keeratS/445team27/README.md

# 445team27
a repo to serve as a git-based lab notebook for the work of Team 27 in ECE 445
