keeratS/445team27/notebooks/jyotsna/AC_data_collection_2_19_2022.png

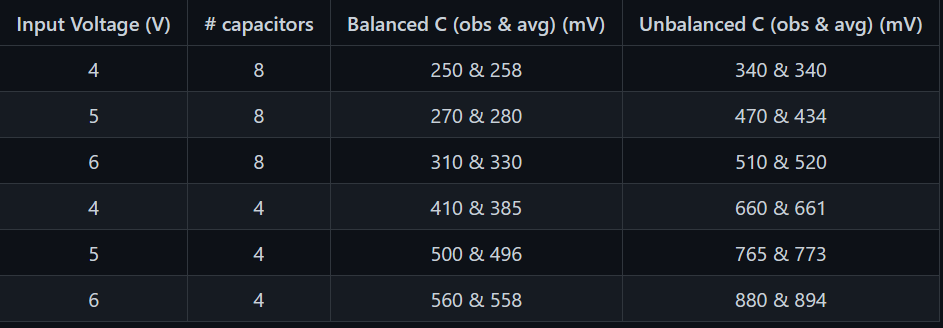
notebooks/jyotsna/AC_data_collection_2_19_2022.png
