keeratS/445team27/notebooks/jyotsna/block_diagram_DDC.png

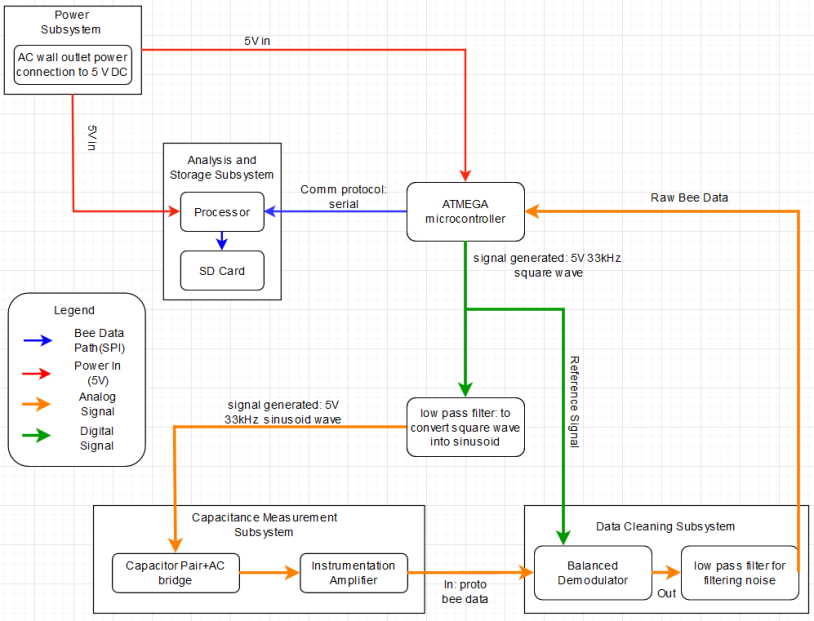
notebooks/jyotsna/block_diagram_DDC.png
