keeratS/445team27/notebooks/keerat/beehouse_dim.jpg

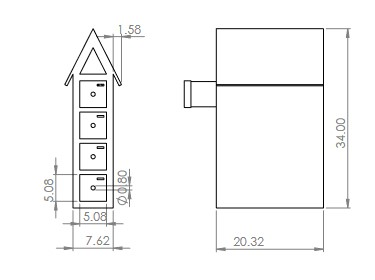
notebooks/keerat/beehouse_dim.jpg
