keeratS/445team27/notebooks/keerat/capacitor_pair_dim.jpg

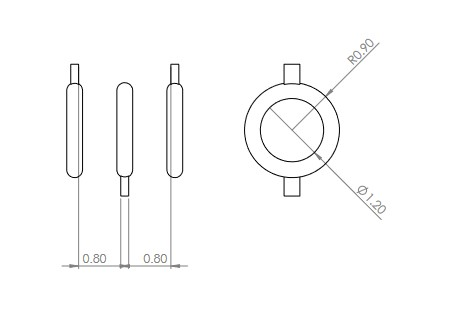
notebooks/keerat/capacitor_pair_dim.jpg
