keeratS/445team27/notebooks/keerat/Change in AC Bridge Output Voltage vs Input Voltage.png

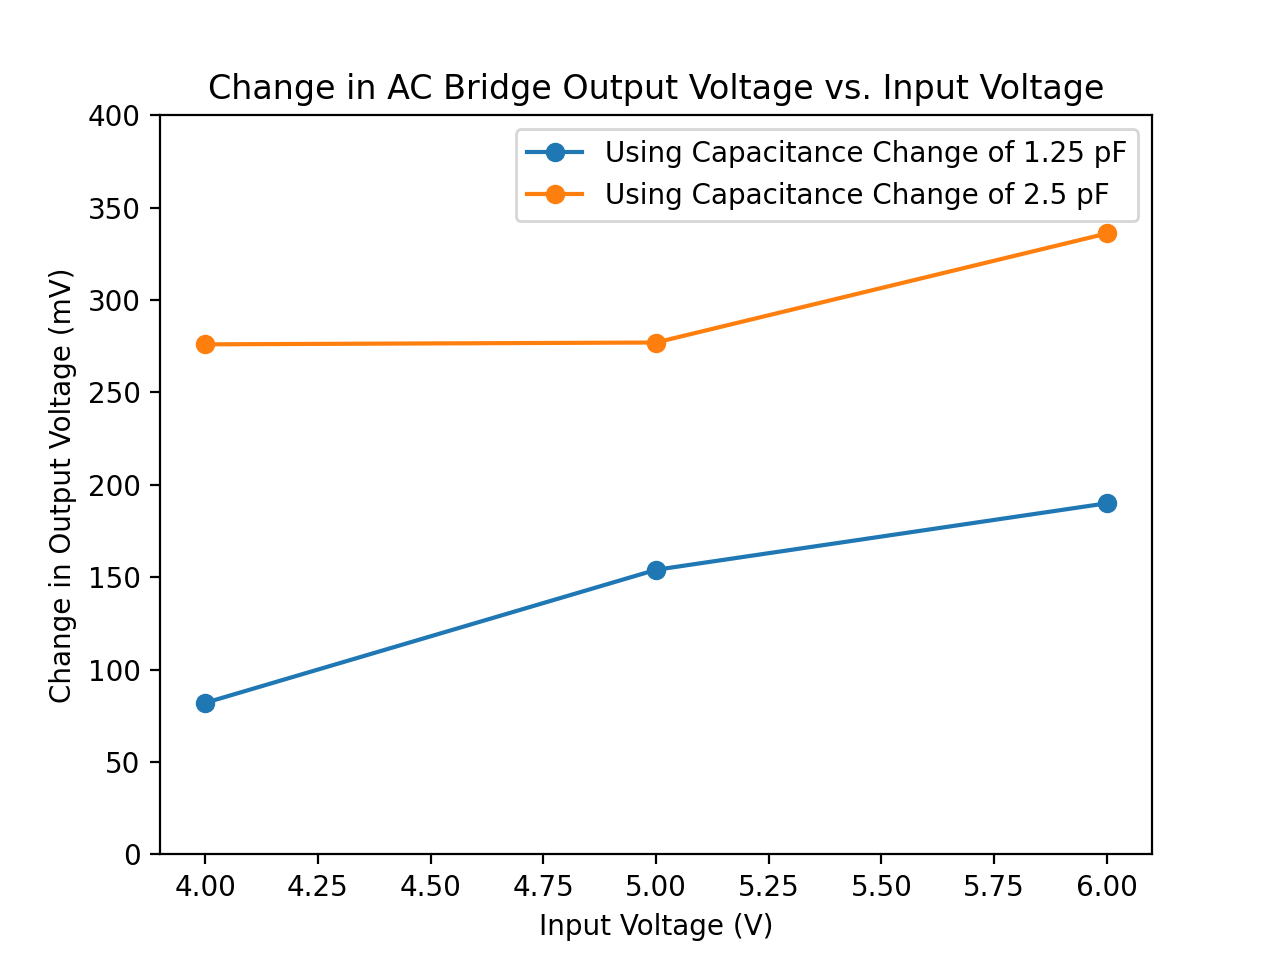
notebooks/keerat/Change in AC Bridge Output Voltage vs Input Voltage.png
