keeratS/445team27/notebooks/keerat/deltacapvsdeltaV.png

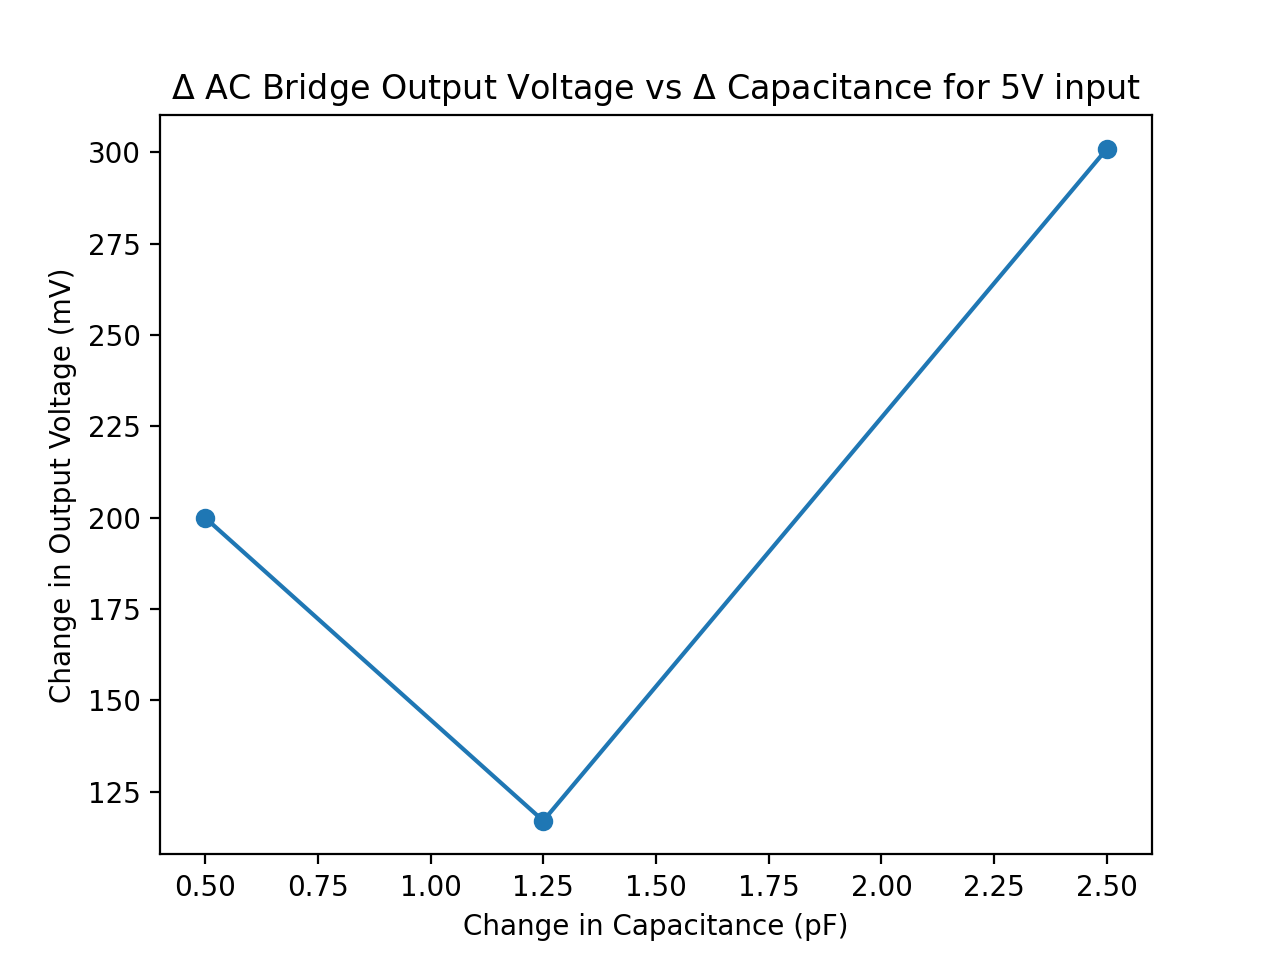
notebooks/keerat/deltacapvsdeltaV.png
