keeratS/445team27/notebooks/keerat/tunnel_dim.jpg

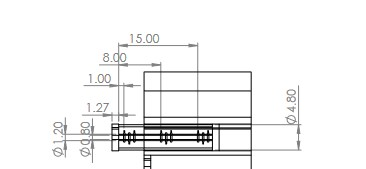
notebooks/keerat/tunnel_dim.jpg
