keeratS/445team27/boards/sensor_board/sensor_board_bom.xlsx

Part | Unit Cost | Number of Units Per Board | Number of Boards | Already Have | Number of Extras | Total Count | Total Cost | Link
0805 10K SMD Resistor | $0.10 | 2 | 3 | 0 | 1 | 7 | $0.70 | https://www.mouser.com/ProductDetail/71-CRCW080510K0FKEAC
AD620 Instrumentation Amp Through Hole | $20.58 | 1 | 3 | 2 | 0 | 1 | $20.58 | https://www.digikey.com/en/products/detail/analog-devices-inc./AD620BNZ/699482
AD630 Balanced Demodulator Through Hole | $39.04 | 1 | 3 | 1 | 0 | 2 | $78.08 | https://www.mouser.com/ProductDetail/Analog-Devices/AD630JNZ?qs=NmRFExCfTkEPgLFWnIxFow%3D%3D
0805 1K SMD Resistor | $0.11 | 6 | 3 | 0 | 1 | 19 | $2.09 | https://www.mouser.com/ProductDetail/Panasonic/ERJ-P06J102V?qs=PVidsWntdHzyQweDjPKezg%3D%3D
uA741 Op Amp Through Hole | $0.00 | 2 | 3 | 0 | 1 | 7 | $0.00 | ECE Services Shop
0805 200K SMD Resistor | $0.18 | 1 | 3 | 0 | 1 | 4 | $0.72 | https://www.mouser.com/ProductDetail/Panasonic/ERJ-P06F2003V?qs=%252B0UA1DFp105fZYiyuaOycA%3D%3D
0805 200nF SMD Capacitor | $2.88 | 1 | 3 | 0 | 1 | 4 | $11.52 | https://www.digikey.com/en/products/detail/rubycon/16MU224MZ22012/4969520
0805 1uF SMD Capacitor | $0.47 | 1 | 3 | 0 | 1 | 4 | $1.88 | https://www.mouser.com/ProductDetail/Taiyo-Yuden/HMJ212DC7105MGHTE
 |  |  |  |  | Total | $115.57
