keeratS/445team27/(commit log)

2022-02-10 pictures of CAD 2/10
2022-02-10 updated w images of house CAD
2022-02-20 added info about prototype circuit and data collection from 2/19
2022-02-21 Create Dialectric Material Research
    base structure of dielectric constant research, not complete
2022-02-21 Update Dialectric Material Research
    figures on capacitance updated ; materials list required still
2022-02-21 Update Dialectric Material Research
    all figures updated, conclusion drawn, current simulation material recommendation stated
2022-02-24 adding CAD drawings with dimensions
2022-03-04 started schematic and PCB
    [senior_design.kicad_pcb, senior_design.kicad_sch]
2022-03-04 added balanced demodulator to schematic
    [senior_design.kicad_sch]
2022-03-07 finished schematic
    [UA741CP.step, senior_design.kicad_sch]
2022-03-08 added footprints, fixed error in schematic, started PCB layout
    [UA741CP.step, senior_design.kicad_pcb, senior_design.kicad_sch]
2022-03-08 changed schematic for 4 boards instead of 1
    [senior_design.kicad_pcb, senior_design.kicad_sch]
2022-03-08 finished PCB for sensor board
    [senior_design.kicad_pcb, senior_design.kicad_sch]
2022-03-08 updated schematic text
    [senior_design.kicad_sch]
2022-03-08 added VCC plane and generated gerber file
    [senior_design-B_Cu.gbr, senior_design-B_Mask.gbr, senior_design-B_Paste.gbr, senior_design-B_Silkscreen.gbr, senior_design-Edge_Cuts.gbr, senior_design-F_Cu.gbr, senior_design-F_Mask.gbr, senior_design-F_Paste.gbr]
2022-03-22 undoing accidental overwrite of PCB stuff
2022-03-22 Revert "Merge branch 'main' of github.com:keeratS/445team27 into main"
    This reverts commit 777689c8a8ad57f7277eda5b46fe19858a00a95d, reversing
    changes made to 7e022650be9491f24625faac10ecfe32b749daf8.
    undoing mistaken merge
    [UA741CP.step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]
2022-03-23 merging local changes
    [senior_design-B_Cu.gbr, senior_design-B_Mask.gbr, senior_design-B_Paste.gbr, senior_design-B_Silkscreen.gbr, senior_design-Edge_Cuts.gbr, senior_design-F_Cu.gbr, senior_design-F_Mask.gbr, senior_design-F_Paste.gbr]
2022-04-12 Update Lab Work Documentation
    April 10 power supply work updated
2022-04-25 added code for arduino tube readings and writing on SD card
2022-04-26 fix to display code
    [display.py]
