keeratS/445team27/notebooks/piyush/microcontroller_board_debugging.jpg

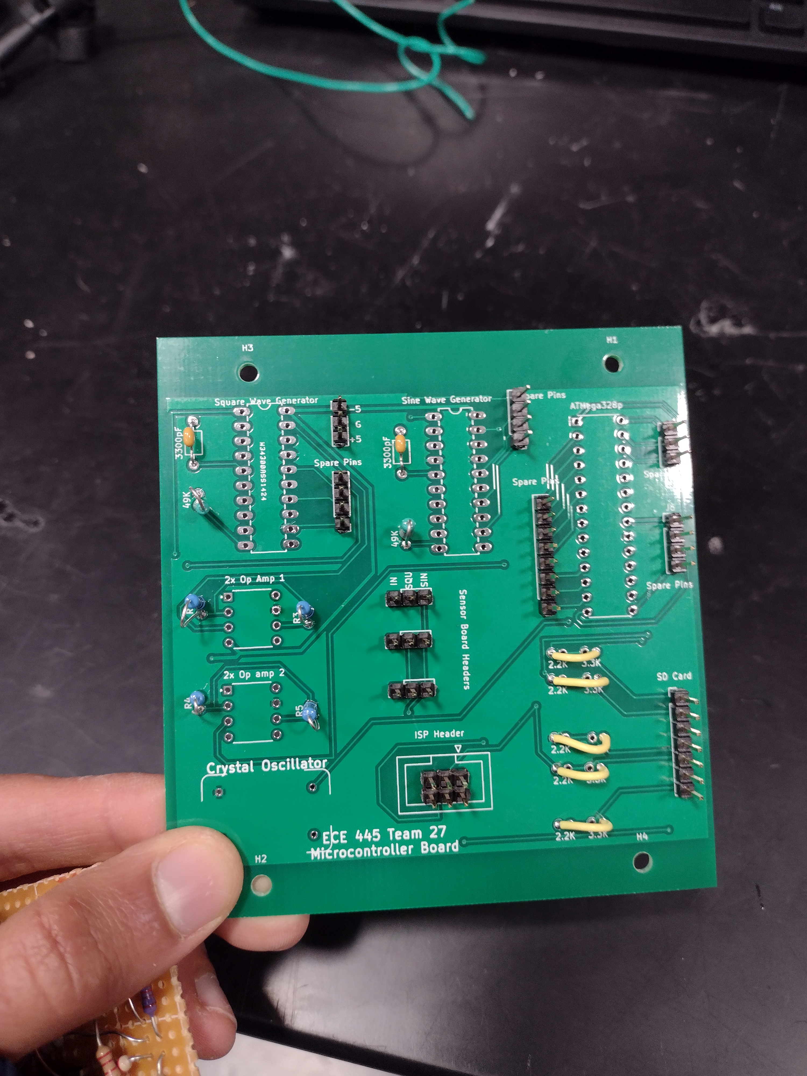
[picture p15: notebooks/piyush/microcontroller_board_debugging.jpg]
notebooks/piyush/microcontroller_board_debugging.jpg
